DrN0psl3d/Frankenbadge/EAGLE/frankenbadge_back.pdf

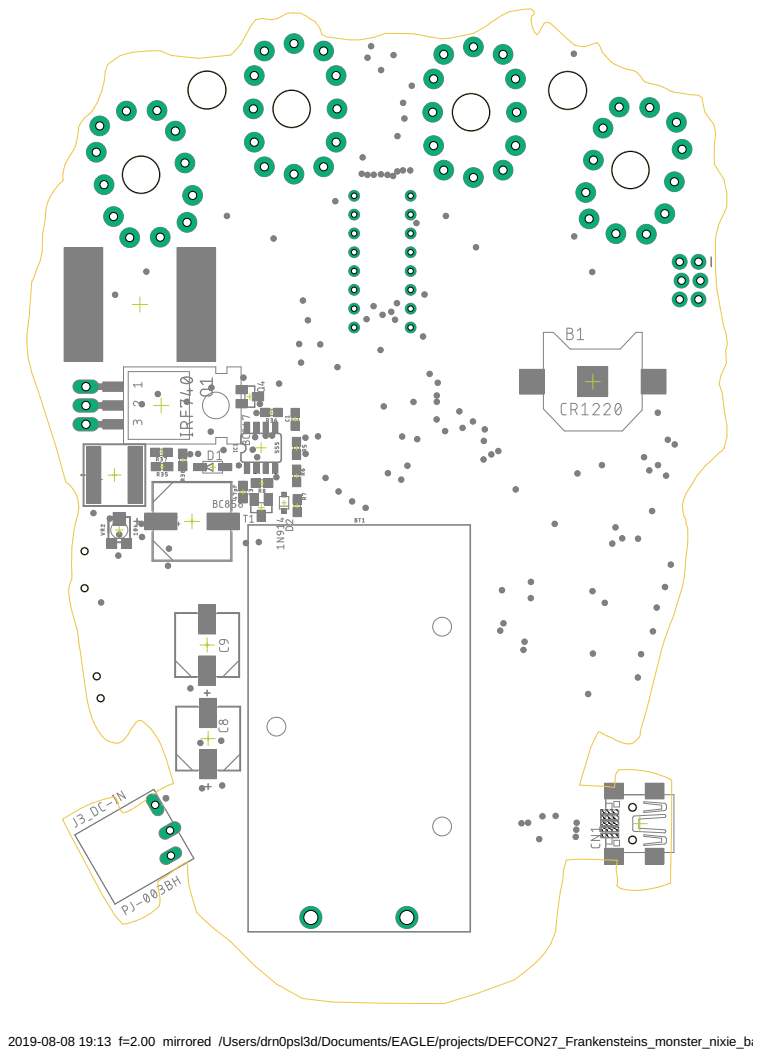
[picture p1: page 1]

2019-08-08 19:13 f=2.00 mirrored /Users/drn0psl3d/Documents/EAGLE/projects/DEFCON27_Frankensteins_monster_nixie_badge/frankenbadge.brd
