DrN0psl3d/Frankenbadge/EAGLE/frankenbadge_front.pdf

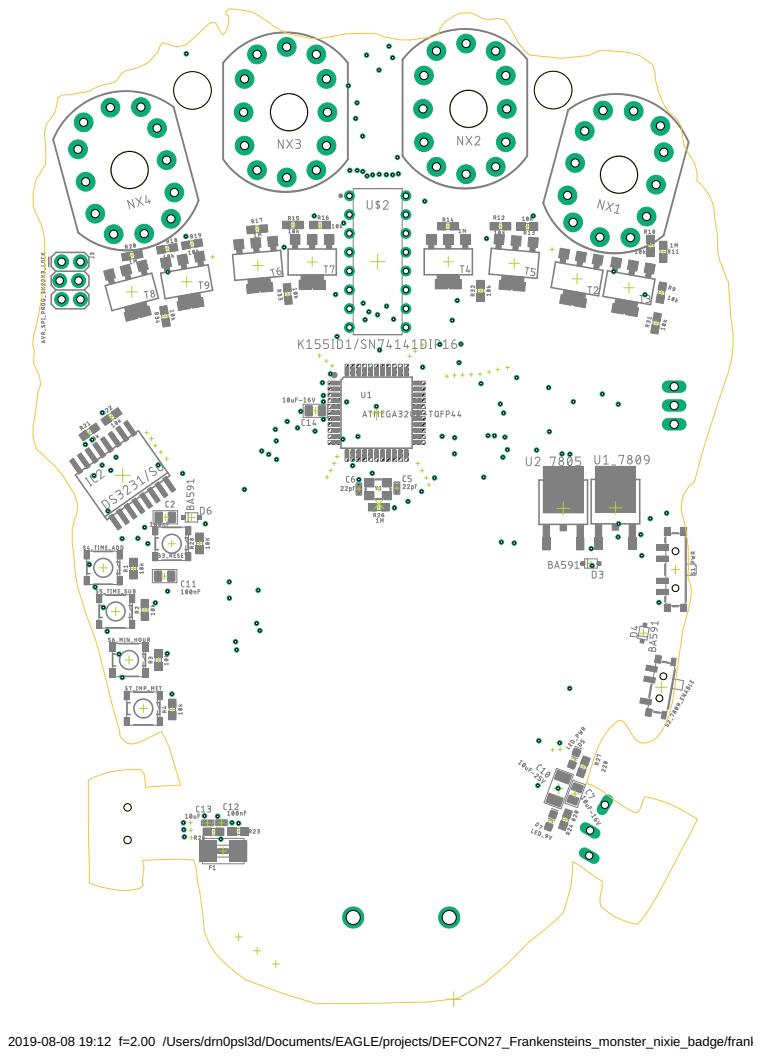
[picture p2: page 1]

2019-08-08 19:12 f=2.00 /Users/drn0psl3d/Documents/EAGLE/projects/DEFCON27_Frankensteins_monster_nixie_badge/frankenbadge.brd
