DrN0psl3d/Frankenbadge/EAGLE/frankenbadge.sch

## EAGLE design EAGLE/frankenbadge.sch (2019-08-31)

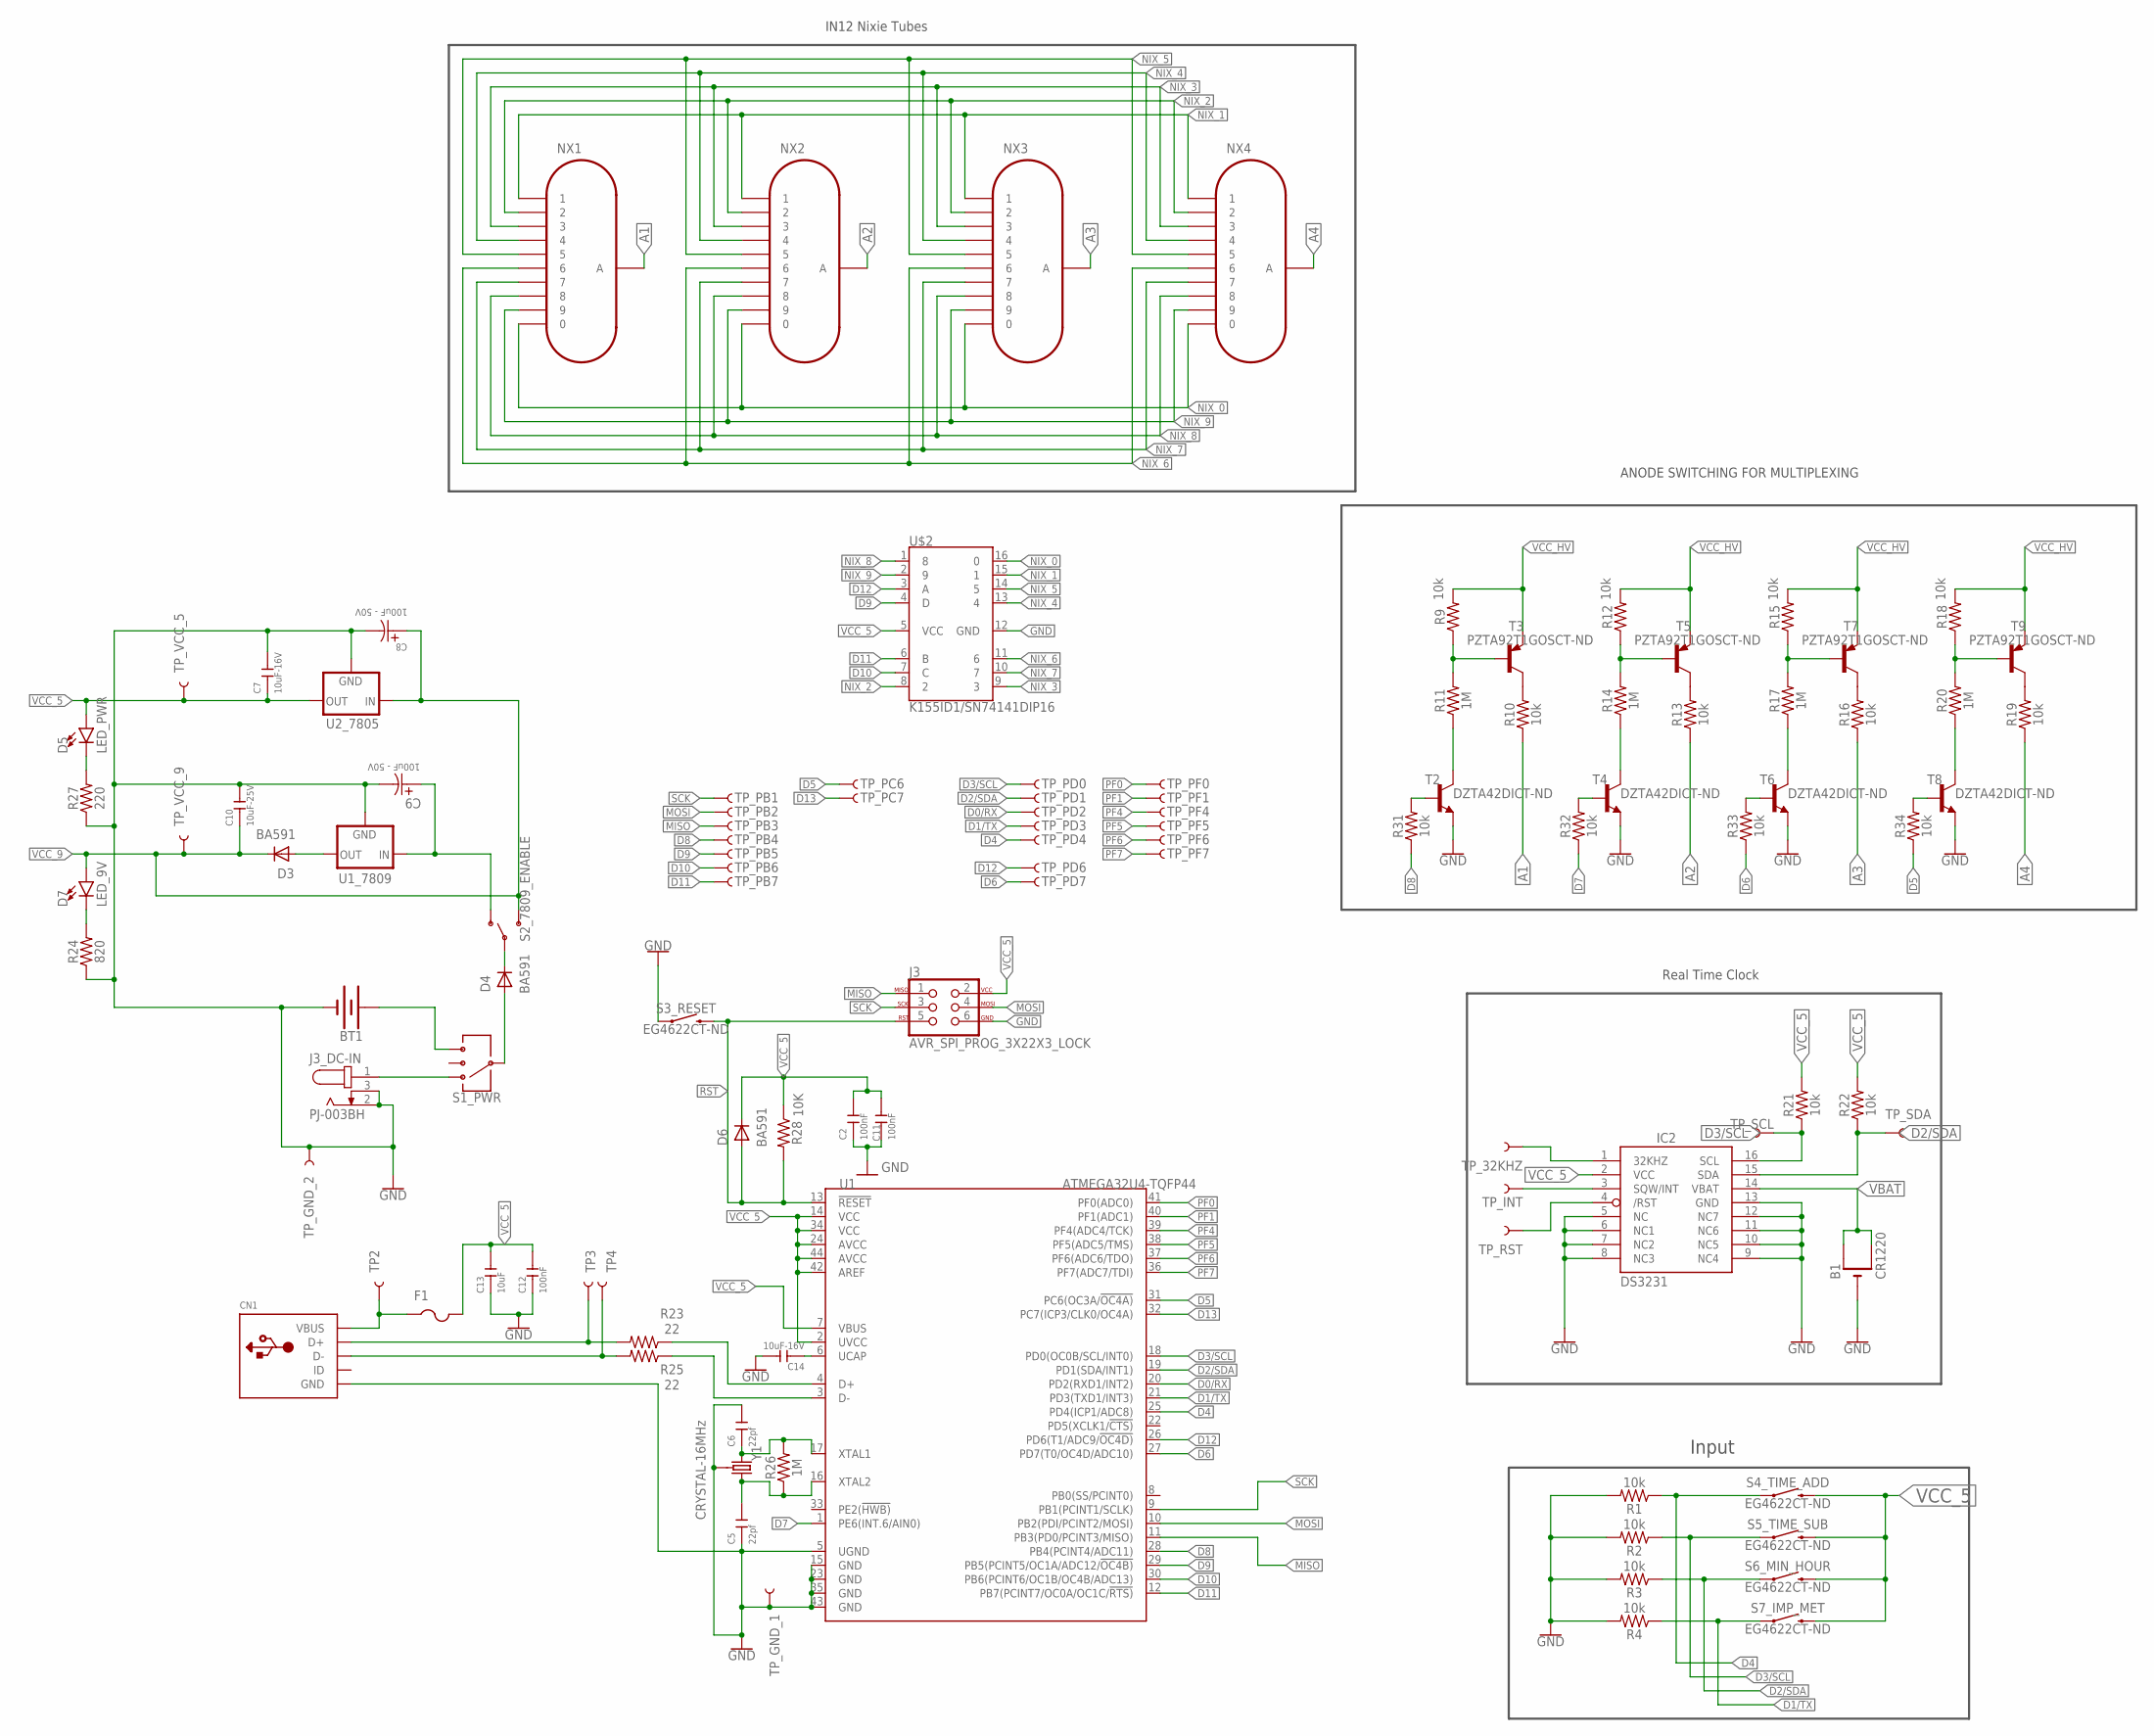
[picture p3: schematic frankenbadge.sch, sheet 1]

Parts:
B1: CR1220; CR1220-SMD
BT1: BATTERY-9V; BATTCON_9V
C2, C11: 100nF; C0805
C5, C6: 22pf; C0402
C7, C14: 10uF-16V; C0805
C8, C9: 100uF - 50V; PCAP_8X10-ELECT-M
C10: 10uF-25V; C1206
C12: 100nF; C0402
C13: 10uF; C0402
CN1: USBMINIB; USB-MINIB
D3, D4, D6: BA591; SOD323(F)
D5: LED_PWR; LED-0603
D7: LED_9V; LED-0603
F1: PTCFUSE-1812; 1812
IC2: DS3231/SO; SO16W
J3: AVR_SPI_PROG_3X22X3_LOCK; 2X3_LOCK
J3_DC-IN: PJ-003BH; CUI_PJ-003BH
NX1, NX2, NX3, NX4: IN-12A; IN-12
R1, R2, R3, R4, R9, R10, R12, R13, R15, R16, R18, R19, R21, R22, R31, R32, R33, R34: 10k; 0603
R11, R14, R17, R20, R26: 1M; 0603
R23, R25: 22; 0603
R24: 820; 0603
R27: 220; 0603
R28: 10K; 0603
S1_PWR: SWITCH-SP3T-SMD; SWITCH_SP3T_SMD
S2_7809_ENABLE: SWITCH-SPDT-SMD-RIGHT-ANGLE; SWITCH_SPST_SMD_A
S3_RESET, S4_TIME_ADD, S5_TIME_SUB, S6_MIN_HOUR, S7_IMP_MET: EG4622CT-ND; TACTILE_SWITCH_SMD_4.5MM
T2, T4, T6, T8: DZTA42DICT-ND; SOT223
T3, T5, T7, T9: PZTA92T1GOSCT-ND; SOT223
TP2, TP3, TP4: TEST-POINT3; PAD.03X.03
TP_32KHZ: TEST-POINT3; PAD.03X.03
TP_GND_1, TP_GND_2: TEST-POINT3; PAD.03X.03
TP_INT: TEST-POINT3; PAD.03X.03
TP_PB1, TP_PB2, TP_PB3, TP_PB4, TP_PB5, TP_PB6, TP_PB7: TEST-POINT3; PAD.03X.03
TP_PC6, TP_PC7: TEST-POINT3; PAD.03X.03
TP_PD0, TP_PD1, TP_PD2, TP_PD3, TP_PD4, TP_PD6, TP_PD7: TEST-POINT3; PAD.03X.03
TP_PF0, TP_PF1, TP_PF4, TP_PF5, TP_PF6, TP_PF7: TEST-POINT3; PAD.03X.03
TP_RST: TEST-POINT3; PAD.03X.03
TP_SCL: TEST-POINT3; PAD.03X.03
TP_SDA: TEST-POINT3; PAD.03X.03
TP_VCC_5, TP_VCC_9: TEST-POINT3; PAD.03X.03
U1: ATMEGA32U4-TQFP44; TQFP44-0.8-9.6X9.6MM
U1_7809, U2_7805: +12v; TO-252
U$2: K155ID1/SN74141DIP16; DIP762W53P254L1969H508Q16B
Y1: CRYSTAL-16MHz; CRYSTAL-SMD-3.2X2.5MM

Connections:
32KHZ: IC2.1 (32KHZ), TP_32KHZ.P$1
A1: NX1.A, R10.1
A2: NX2.A, R13.1
A3: NX3.A, R16.1
A4: NX4.A, R19.1
D0/RX: TP_PD2.P$1, U1.20 (PD2(RXD1/INT2))
D1/TX: R4.1, S7_IMP_MET.2 (1), TP_PD3.P$1, U1.21 (PD3(TXD1/INT3))
D2/SDA: IC2.15 (SDA), R3.1, R22.1, S6_MIN_HOUR.2 (1), TP_PD1.P$1, TP_SDA.P$1, U1.19 (PD1(SDA/INT1))
D3/SCL: IC2.16 (SCL), R2.1, R21.1, S5_TIME_SUB.2 (1), TP_PD0.P$1, TP_SCL.P$1, U1.18 (PD0(OC0B/SCL/INT0))
D4: R1.1, S4_TIME_ADD.2 (1), TP_PD4.P$1, U1.25 (PD4(ICP1/ADC8))
D5: R34.1, TP_PC6.P$1, U1.31 (PC6(OC3A/!OC4A))
D6: R33.1, TP_PD7.P$1, U1.27 (PD7(T0/OC4D/ADC10))
D7: R32.1, U1.1 (PE6(INT.6/AIN0))
D8: R31.1, TP_PB4.P$1, U1.28 (PB4(PCINT4/ADC11))
D9: TP_PB5.P$1, U1.29 (PB5(PCINT5/OC1A/ADC12/!OC4B)), U$2.4 (D)
D10: TP_PB6.P$1, U1.30 (PB6(PCINT6/OC1B/OC4B/ADC13)), U$2.7 (C)
D11: TP_PB7.P$1, U1.12 (PB7(PCINT7/OC0A/OC1C/!RTS)), U$2.6 (B)
D12: TP_PD6.P$1, U1.26 (PD6(T1/ADC9/!OC4D)), U$2.3 (A)
D13: TP_PC7.P$1, U1.32 (PC7(ICP3/CLK0/OC4A))
DS_RST: IC2.4 (/RST), TP_RST.P$1
GND: B1.-, BT1.-, C2.1, C5.1, C6.2, C7.2, C8.2, C9.2, C10.2, C11.1, C12.1, C13.1, C14.2, CN1.GND, IC2.5 (NC), IC2.6 (NC1), IC2.7 (NC2), IC2.8 (NC3), IC2.9 (NC4), IC2.10 (NC5), IC2.11 (NC6), IC2.12 (NC7), IC2.13 (GND), J3.6, J3_DC-IN.2, J3_DC-IN.3, R1.2, R2.2, R3.2, R4.2, R24.1, R27.1, S3_RESET.2 (1), T2.3 (E), T4.3 (E), T6.3 (E), T8.3 (E), TP_GND_1.P$1, TP_GND_2.P$1, U1.5 (UGND), U1.15 (GND), U1.23 (GND), U1.35 (GND), U1.43 (GND), U1_7809.3 (GND), U2_7805.3 (GND), U$2.12 (GND), Y1.2 (3)
INT: IC2.3 (SQW/INT), TP_INT.P$1
MISO: J3.1, TP_PB3.P$1, U1.11 (PB3(PD0/PCINT3/MISO))
MOSI: J3.4, TP_PB2.P$1, U1.10 (PB2(PDI/PCINT2/MOSI))
unnamed: R31.2, T2.1 (B)
unnamed: R32.2, T4.1 (B)
unnamed: R33.2, T6.1 (B)
unnamed: R34.2, T8.1 (B)
unnamed: R10.2, T3.2 (C)
unnamed: C14.1, U1.6 (UCAP)
unnamed: R9.1, R11.2, T3.1 (B)
unnamed: R11.1, T2.2 (C)
unnamed: R13.2, T5.2 (C)
unnamed: R12.1, R14.2, T5.1 (B)
unnamed: R14.1, T4.2 (C)
unnamed: R16.2, T7.2 (C)
unnamed: R15.1, R17.2, T7.1 (B)
unnamed: R17.1, T6.2 (C)
unnamed: R19.2, T9.2 (C)
unnamed: R18.1, R20.2, T9.1 (B)
unnamed: R20.1, T8.2 (C)
unnamed: BT1.+, S1_PWR.4
unnamed: J3_DC-IN.1, S1_PWR.1
unnamed: D4.2 (A), S1_PWR.3
unnamed: D4.1 (K), S2_7809_ENABLE.2
unnamed: C9.1, S2_7809_ENABLE.1 (O), U1_7809.1 (IN)
unnamed: D5.C, R27.2
unnamed: D3.2 (A), U1_7809.2 (OUT)
unnamed: D7.C, R24.2
unnamed: C6.1, R26.2, U1.17 (XTAL1), Y1.1
unnamed: R23.1, U1.4 (D+)
unnamed: R25.1, U1.3 (D-)
unnamed: C5.2, R26.1, U1.16 (XTAL2), Y1.3 (2)
NIX_0: NX1.0, NX2.0, NX3.0, NX4.0, U$2.16 (0)
NIX_1: NX1.1, NX2.1, NX3.1, NX4.1, U$2.15 (1)
NIX_2: NX1.2, NX2.2, NX3.2, NX4.2, U$2.8 (2)
NIX_3: NX1.3, NX2.3, NX3.3, NX4.3, U$2.9 (3)
NIX_4: NX1.4, NX2.4, NX3.4, NX4.4, U$2.13 (4)
NIX_5: NX1.5, NX2.5, NX3.5, NX4.5, U$2.14 (5)
NIX_6: NX1.6, NX2.6, NX3.6, NX4.6, U$2.11 (6)
NIX_7: NX1.7, NX2.7, NX3.7, NX4.7, U$2.10 (7)
NIX_8: NX1.8, NX2.8, NX3.8, NX4.8, U$2.1 (8)
NIX_9: NX1.9, NX2.9, NX3.9, NX4.9, U$2.2 (9)
PF0: TP_PF0.P$1, U1.41 (PF0(ADC0))
PF1: TP_PF1.P$1, U1.40 (PF1(ADC1))
PF4: TP_PF4.P$1, U1.39 (PF4(ADC4/TCK))
PF5: TP_PF5.P$1, U1.38 (PF5(ADC5/TMS))
PF6: TP_PF6.P$1, U1.37 (PF6(ADC6/TDO))
PF7: TP_PF7.P$1, U1.36 (PF7(ADC7/TDI))
RST: D6.2 (A), J3.5, R28.2, S3_RESET.1 (2), U1.13 (!RESET)
SCK: J3.3, TP_PB1.P$1, U1.9 (PB1(PCINT1/SCLK))
USB_D+: CN1.D+, R23.2, TP3.P$1
USB_D-: CN1.D-, R25.2, TP4.P$1
VBAT: B1.+$1 (+), B1.+$2 (+1), IC2.14 (VBAT)
VBUS: CN1.VBUS, F1.1, TP2.P$1
VCC_5: C2.2, C7.1, C11.2, C12.2, C13.2, D5.A, D6.1 (K), F1.2, IC2.2 (VCC), J3.2, R21.2, R22.2, R28.1, S4_TIME_ADD.1 (2), S5_TIME_SUB.1 (2), S6_MIN_HOUR.1 (2), S7_IMP_MET.1 (2), TP_VCC_5.P$1, U1.2 (UVCC), U1.7 (VBUS), U1.14 (VCC), U1.24 (AVCC), U1.34 (VCC), U1.42 (AREF), U1.44 (AVCC), U2_7805.2 (OUT), U$2.5 (VCC)
VCC_9: C8.1, C10.1, D3.1 (K), D7.A, S2_7809_ENABLE.3 (S), TP_VCC_9.P$1, U2_7805.1 (IN)
VCC_HV: R9.2, R12.2, R15.2, R18.2, T3.3 (E), T5.3 (E), T7.3 (E), T9.3 (E)

Notes on the sheet:
IN12 Nixie Tubes
ANODE SWITCHING FOR MULTIPLEXING
Real Time Clock
Input

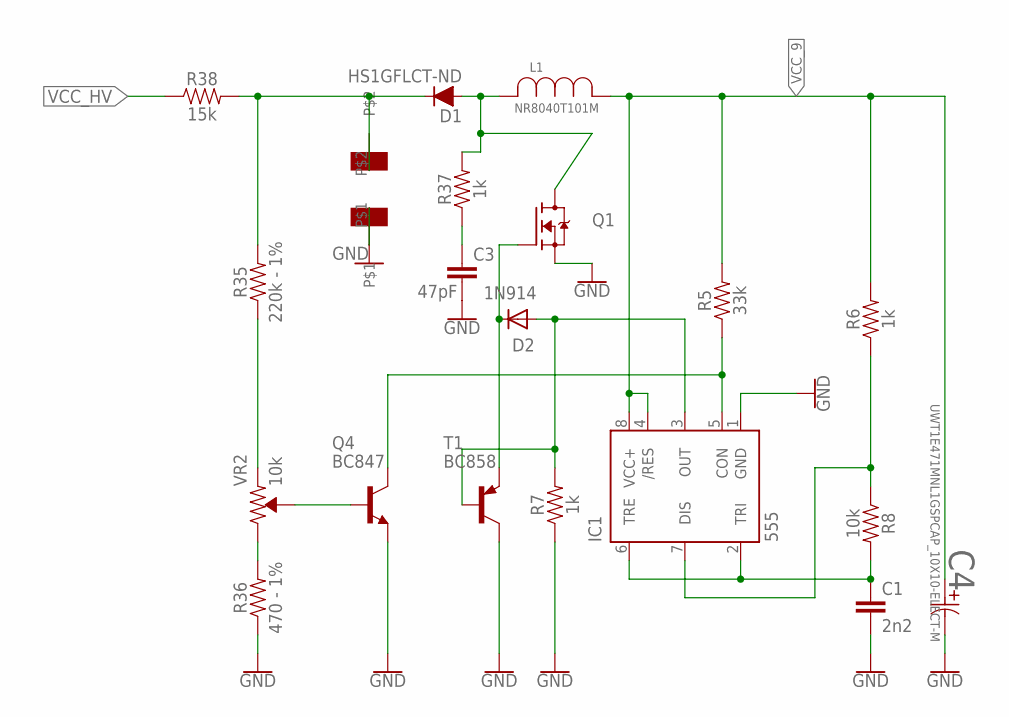
[picture p4: schematic frankenbadge.sch, sheet 2]

Parts:
C1: 2n2; 0603
C3: 47pF; 0603
C4: UWT1E471MNL1GSPCAP_10X10-ELECT-M; PCAP_10X10-ELECT-M
D1: HS1GFLCT-ND; SOD123
D2: 1N914; SOD323(F)
IC1: 555; SO08
L1: NR8040T101M; IND_TAIYO_NR8040
Q1: IRF740; TO220_NO_HOLE
Q4: BC847; SOT23
R5: 33k; 0603
R6, R7, R37: 1k; 0603
R8: 10k; 0603
R35: 220k - 1%; 0603
R36: 470 - 1%; 0603
R38: 15k; 0603
T1: BC858; SOT23
U$7: SMD_6054
VR2: 10k; TRIMPOT-SMD-TC33X

Connections:
GND: C1.2, C3.2, C4.2, IC1.1 (GND), Q1.3 (S), Q4.2 (E), R7.1, R36.1, T1.3 (C), U$7.P$1
unnamed: IC1.7 (DIS), R6.1, R8.1
unnamed: IC1.5 (CON), Q4.3 (C), R5.1
unnamed: D2.2 (A), IC1.3 (OUT), R7.2, T1.1 (B)
unnamed: C1.1, IC1.2 (TRI), IC1.6 (TRE), R8.2
unnamed: D1.1 (C), R35.2, R38.2, U$7.P$2
unnamed: R35.1, VR2.3 (CCW)
unnamed: Q4.1 (B), VR2.2 (WIPER)
unnamed: R36.2, VR2.1 (CW)
unnamed: C3.1, R37.1
unnamed: D1.2 (A), L1.2, Q1.2 (D), R37.2
unnamed: D2.1 (K), Q1.1 (G), T1.2 (E)
VCC_9: C4.1, IC1.4 (/RES), IC1.8 (VCC+), L1.1, R5.2, R6.2
VCC_HV: R38.1
